ziweizhan1993-arch/desktop/01_3D打印文件/打印说明.md

# 3D 打印说明

## 直接打印（推荐）

三个零件都在 `拓竹看板_外壳.3mf` 里，方向已经摆好：

| 零件 | 打印方向 | 尺寸 |
|---|---|---|
| 前壳 | 正面朝下贴热床 | 117.4 × 65.4 × 40 mm |
| 后盖 | 背面朝下，压柱朝上 | 117.4 × 65.4 × 34.6 mm |
| 支架 | 平放，两只脚在同一个文件里 | 99.4 × 53.2 × 26.2 mm |

怎么打：

1. 用 Bambu Studio 打开 `拓竹看板_外壳.3mf`。
2. 这个工程是按 **H2C、0.4 喷嘴、PLA、0.20 mm** 切的。用 A1、P1 或 X1 时，左上角换成自己的打印机，再切片。
3. H2C 上三件一起大约 **2 小时、68 g**。
4. 推荐前壳、后盖用哑光炭黑，支架用拓竹绿。没有 AMS 就分两次打。

## 打印参数

工程里已经设好，单独打开 STL 时按这张表：

| 参数 | 设置 |
|---|---|
| 层高 | 0.20 mm |
| 墙层数 | 2 |
| 填充 | 10%，螺旋体 |
| 支撑 | 不需要 |
| 热床 | 光面 PEI 正面更平整；纹理 PEI 会在前壳正面留下颗粒 |
| 材料 | PLA。工程板打 PLA 时先薄涂一层胶棒 |

## 其他文件

`STL备用/` 是同样的三个零件，给 Cura 或其他切片软件用。方向和上表一致，导入后不用再转。

## 打完检查

1. 前壳窗口大约 85.5 × 57.7 mm，四边圆角完整。
2. 左侧有两个竖着的 Type-C 孔，顶部有散热槽。
3. 后盖能斜着把顶部两个卡扣挂进前壳，再压到底。
4. 底部两个沉头孔能从下往上拧进 M2×8 自攻螺丝。
