ziweizhan1993-arch/desktop/03_接线图/接线说明.md

# 接线说明

先看两张图：

- `01_屏幕接线.png`：转接板 14 针，从左到右，第 1 针是 VCC。
- `02_功放接线.png`：MAX98357A。
- `03_开发板5V短接.png`：只有 5V 针没有电压时才需要。有些板子要短接 IN-OUT 焊盘，USB 的 5V 才会从 5V 针送出来，功放才有电。

接线前先拔掉 USB。

## 屏幕

| 转接板（从左数） | ESP32-S3 | 作用 |
|---|---|---|
| 1 VCC | 3V3 | 供电 |
| 2 GND | GND | 地 |
| 3 CS | GPIO 10 | 屏幕片选 |
| 4 RESET | GPIO 14 | 屏幕复位 |
| 5 DC | GPIO 9 | 数据 / 命令 |
| 6 SDI | GPIO 11 | SPI 数据 |
| 7 SCK | GPIO 12 | SPI 时钟 |
| 8 LED | GPIO 21 | 背光 |
| 9 SDO | GPIO 13 | 可不接 |
| 10 T_CLK | GPIO 5 | 触摸时钟 |
| 11 T_CS | GPIO 1 | 触摸片选 |
| 12 T_SDI | GPIO 4 | 触摸数据输入 |
| 13 T_SDO | GPIO 2 | 触摸数据输出，必须接 |
| 14 T_IRQ | GPIO 6 | 触摸中断 |

这是电阻触摸。排针上的 T_CLK、T_CS 不要当成电容屏的 SCL、SDA。第 13 针不接的话，触摸会乱报，把亮度滑条拖暗。

## 功放 MAX98357A

| 功放 | ESP32-S3 |
|---|---|
| BCLK | GPIO 15 |
| LRC | GPIO 16 |
| DIN | GPIO 7 |
| Vin | 5V |
| GND | GND |

喇叭两根线接到功放的喇叭输出，没有正负要求。开发板平放在壳子底部，两个 Type-C 朝左侧那两个竖孔。

## 不要用的引脚

GPIO 35、36、37 是 PSRAM。GPIO 19、20 是原生 USB。GPIO 43、44 是串口。
