ziweizhan1993-arch/desktop/03_接线图/02_功放接线.png

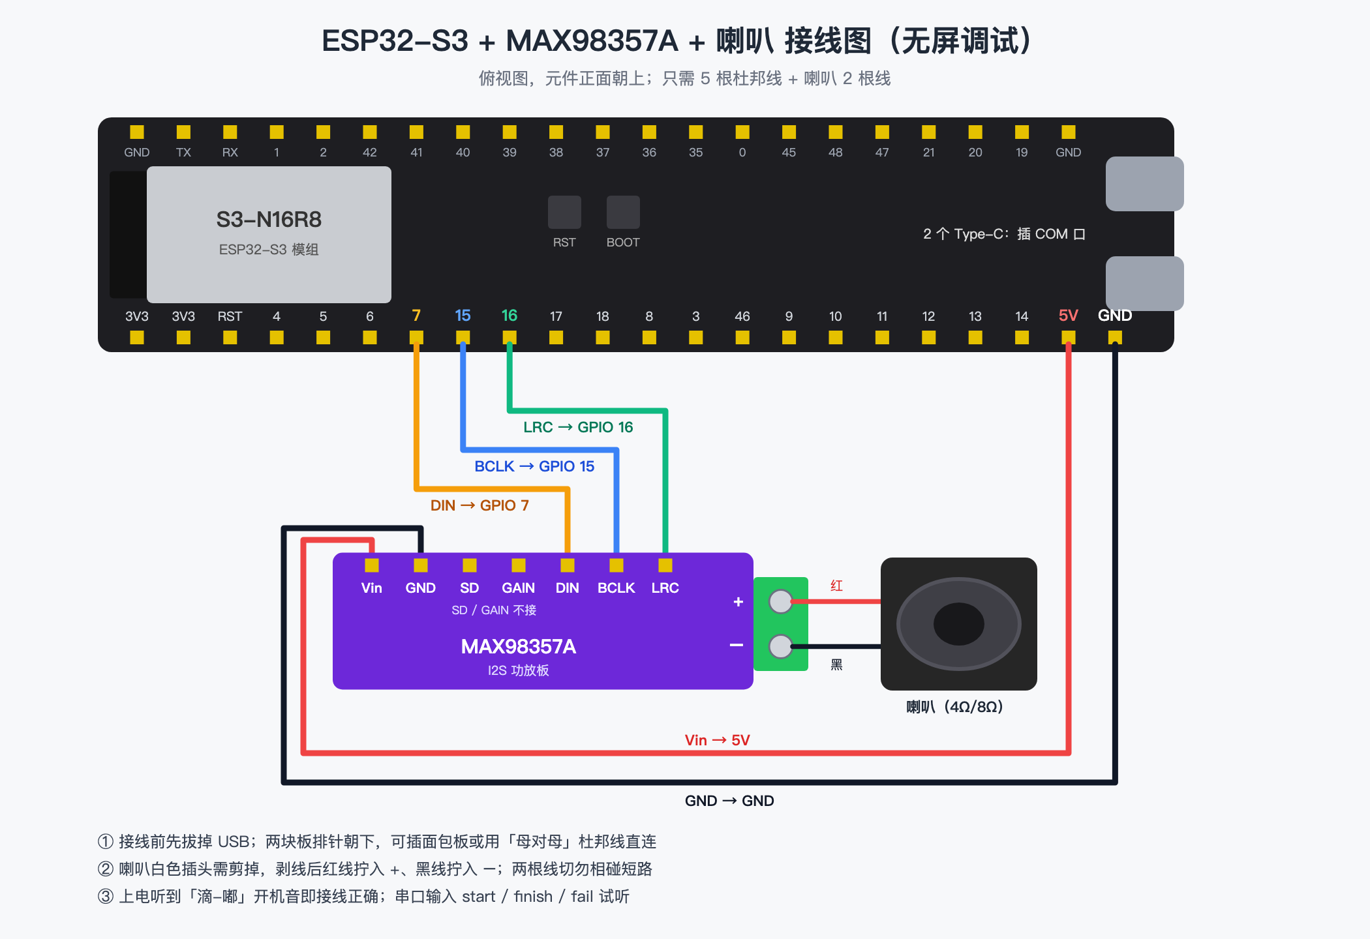
03_接线图/02_功放接线.png
