ziweizhan1993-arch/desktop/03_接线图/03_开发板5V短接.png

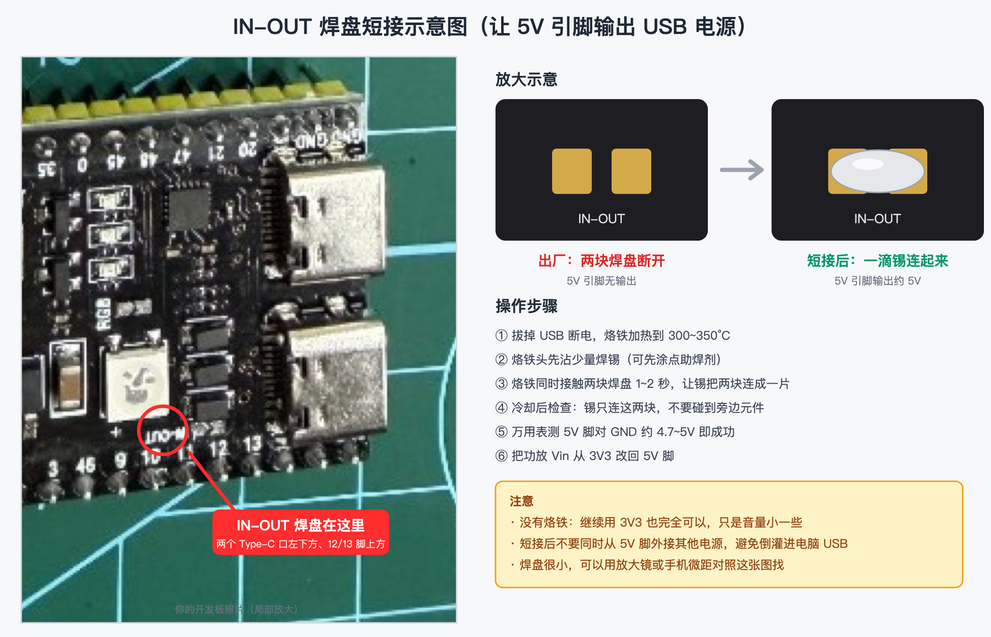
03_接线图/03_开发板5V短接.png
