ziweizhan1993-arch/desktop/05_效果图/03_界面预览.png

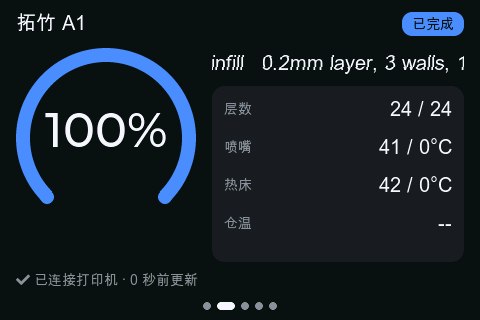
05_效果图/03_界面预览.png
