ziweizhan1993-arch/desktop/04_物料清单/物料清单.md

# 物料清单（BOM）

价格是淘宝常见价，只供参考。搜索关键词可以直接复制去搜。

## 一、电子元件

| # | 名称 | 规格 / 要求 | 数量 | 搜索关键词 | 参考价 |
|---|---|---|---|---|---|
| 1 | 主控板 | **ESP32-S3-N16R8**（16MB Flash + 8MB PSRAM，双 Type-C） | 1 | `ESP32-S3-N16R8 开发板` | ¥30~45 |
| 2 | 屏幕 | **4.0 寸 ST7796**，480×320，40Pin FPC，带 SPI 转接板。本固件按转接板上的**电阻触摸**来写 | 1 | `4.0寸 ST7796 SPI 转接板 40P` | ¥40~60 |
| 3 | 功放 | **MAX98357A** I2S 模块 | 1 | `MAX98357A I2S 功放模块` | ¥5~10 |
| 4 | 喇叭 | 腔体喇叭，大约 70×30 mm，能放进后盖 | 1 | `4欧 3W 腔体喇叭 7030` | ¥8~15 |

## 二、结构件和线

| # | 名称 | 规格 | 数量 | 说明 |
|---|---|---|---|---|
| 5 | 自攻螺丝 | M2×8 | 2 | 从外壳底部往上拧进后盖 |
| 6 | 杜邦线 | 母对母，15 cm 左右 | 约 16 根 | 屏幕 13 根 + 功放 3 根。尽量短，时钟线别和电源捆在一起 |
| 7 | 双面胶 | 泡棉双面胶 | 一小段 | 把开发板粘在壳子底部，插线时不移位 |

## 三、3D 打印材料

| 颜色 | 零件 | 用量 | 推荐 |
|---|---|---|---|
| 哑光炭黑 PLA | 前壳 + 后盖 | 三件合计约 68 g、约 2 小时（H2C，0.20 mm） | 拓竹 PLA Matte 炭黑 |
| 拓竹绿 PLA | 支架 | 同上，和壳体一起切片 | 拓竹 PLA Basic 拓竹绿 |

热床 256 mm 的 X1、P1、A1、H2C 都放得下。A1 mini 也能放下这套 117 mm 的外壳。

## 四、工具

| 工具 | 说明 |
|---|---|
| 能传数据的 USB 线 | 刷固件用。只充电的线电脑认不出板子 |
| 小十字螺丝刀 | 拧底部两颗 M2 |
