ziweizhan1993-arch/desktop/04_物料清单/物料清单.csv

类别 | 名称 | 规格 | 数量 | 搜索关键词 | 参考价
电子 | 主控板 | ESP32-S3-N16R8 | 1 | ESP32-S3-N16R8 开发板 | 30-45
电子 | 屏幕 | 4.0寸 ST7796 SPI 转接板 电阻触摸 | 1 | 4.0寸 ST7796 SPI 转接板 40P | 40-60
电子 | 功放 | MAX98357A I2S | 1 | MAX98357A I2S 功放模块 | 5-10
电子 | 喇叭 | 约70x30mm 腔体喇叭 | 1 | 4欧 3W 腔体喇叭 7030 | 8-15
结构 | 螺丝 | M2x8 自攻 | 2 | M2x8 自攻螺丝 | 1
结构 | 杜邦线 | 母对母 15cm | 16 | 杜邦线 母对母 | 5
打印 | PLA | 哑光炭黑 + 拓竹绿 | 68g | 拓竹 PLA Matte 炭黑 | 按卷计
