ziweizhan1993-arch/desktop/01_3D打印文件/STL备用/2_后盖.stl

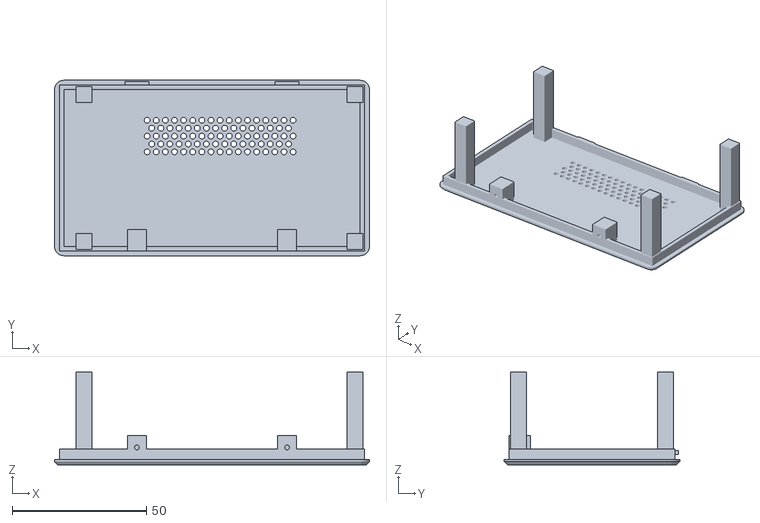
[picture p7: CAD file, 2026-10-05]
01_3D打印文件/STL备用/2_后盖.stl
117.4 x 65.4 x 34.6
