ziweizhan1993-arch/desktop/01_3D打印文件/拓竹看板_外壳.3mf

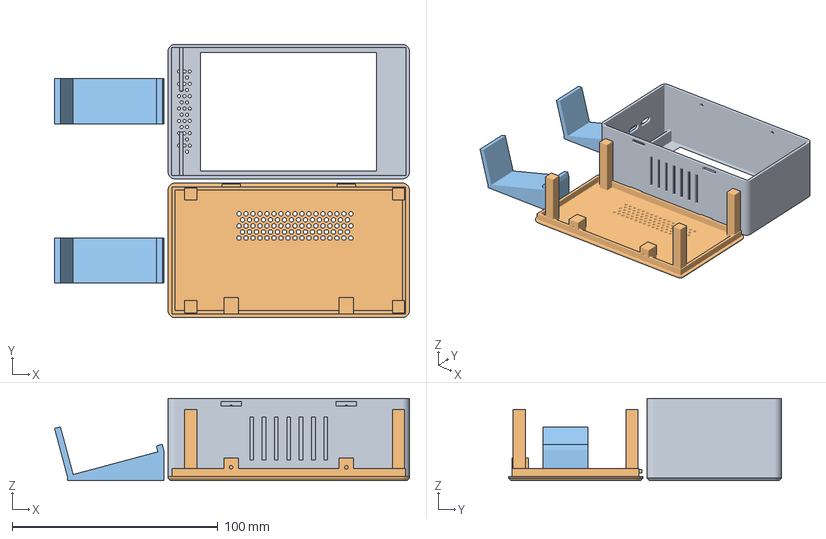
[picture p8: CAD file, 2026-10-05]
01_3D打印文件/拓竹看板_外壳.3mf
172.5 x 132.9 x 40.0 mm
front_shell.stl
back_cover.stl
stand.stl
