ziweizhan1993-arch/desktop/01_3D打印文件/STL备用/1_前壳.stl

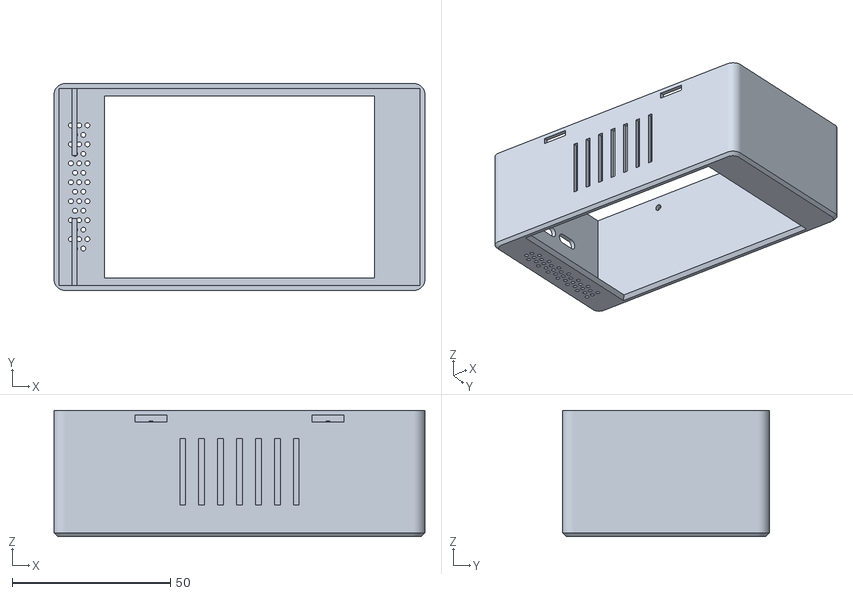
[picture p9: CAD file, 2026-10-05]
01_3D打印文件/STL备用/1_前壳.stl
117.4 x 65.4 x 40.0
