ziweizhan1993-arch/desktop/01_3D打印文件/STL备用/3_支架.stl

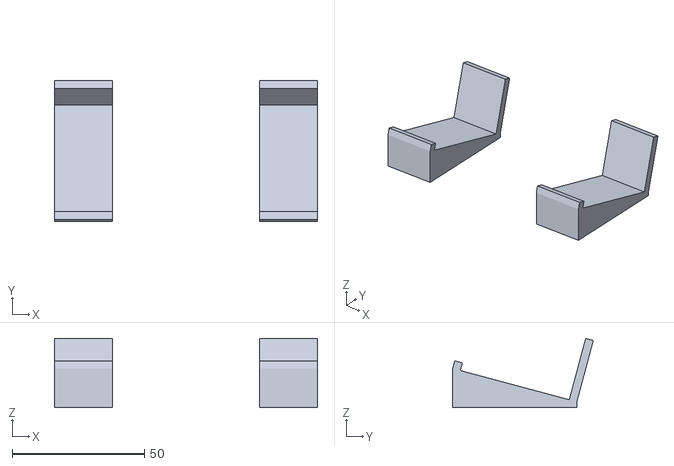
[picture p10: CAD file, 2026-10-05]
01_3D打印文件/STL备用/3_支架.stl
99.4 x 53.2 x 26.2
