ziweizhan1993-arch/desktop/MakerWorld简介.txt

【标题】
桌面拓竹看板｜ESP32-S3 + 4寸触摸屏｜双机状态、天气、提示音｜免支撑

【简介】
一块放在打印机旁边的 4 寸状态屏，横屏滑动就能看完两台拓竹打印机。
· 五页循环：H2C、A1、Cursor 用量、重庆天气、系统设置，城市和打印机名字可改
· 开始打印、打印完成、打印失败各有一段提示音，音量可在屏幕上调
· 30 秒没人触摸就自动翻到下一页；手指按住或刚滑过，就重新计时
· 不用开「仅局域网」，手机 App 照常用；打印机访问码写在配置里
· 外壳三件，全部免支撑。后盖上面两个卡扣，底下两颗 M2 螺丝
· H2C 切片大约 2 小时、68g（0.20 mm，PLA）

【打印】
· 一个 3MF：前壳、后盖、支架已经按打印方向摆好
· 前壳正面朝下，后盖背面朝下，支架平放
· 0.20 mm 层高，2 层墙，10% 螺旋填充，无支撑
· 工程文件按 H2C、0.4 喷嘴、PLA 切过。A1 / P1 / X1 打开后换成自己的机型再切一次
· 用工程板打 PLA 时，热床上薄涂一层胶

【电子元件】
ESP32-S3-N16R8、4.0 寸 ST7796 SPI 转接板（电阻触摸）、MAX98357A 功放、腔体喇叭、M2×8 自攻螺丝 ×2

【附件】
完整教程、接线图、物料清单（含搜索关键词）、PlatformIO 源码都在附件压缩包里。
源码里没有 WiFi 密码和打印机访问码，要自己复制 secrets.example.h 填写。

本作品为个人 DIY，与拓竹实验室官方无关。
