ziweizhan1993-arch/desktop/02_固件/esp32-dashboard/src/audio.h

#pragma once
#include <stdint.h>

enum class Sound : uint8_t { Boot, Click, PrintStart, PrintFinish, PrintFailed };

void audioBegin();
void audioPlay(Sound s);
void audioSetVolume(uint8_t percent);
uint8_t audioGetVolume();
